jdragon3001/SO-ARM100/Build/A1mini/follower/follower_plate_02.stl

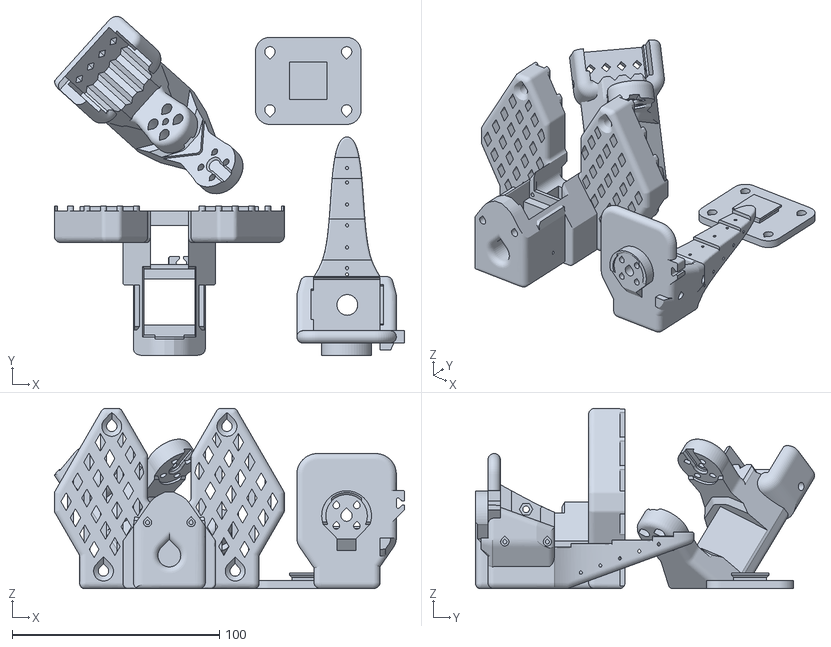
[picture p1: CAD file, 2026-11-04]
Build/A1mini/follower/follower_plate_02.stl
168.9 x 163.5 x 87.0
