jdragon3001/SO-ARM100/Build/A1mini/leader/leader_plate_03.stl

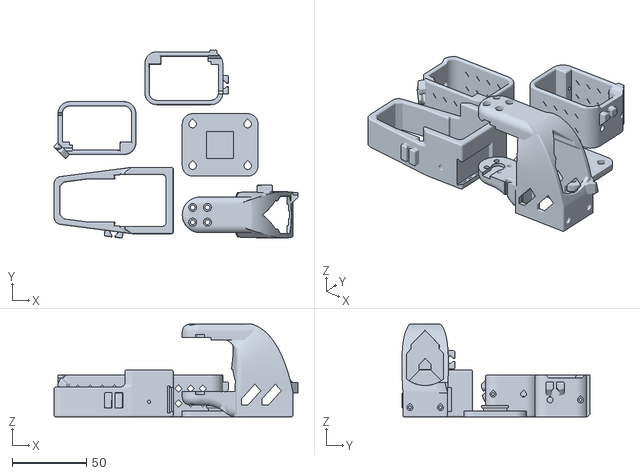
[picture p2: CAD file, 2026-11-04]
Build/A1mini/leader/leader_plate_03.stl
164.0 x 126.6 x 62.3
