jdragon3001/SO-ARM100/Build/Tooling/inspection/receiver_section.stl

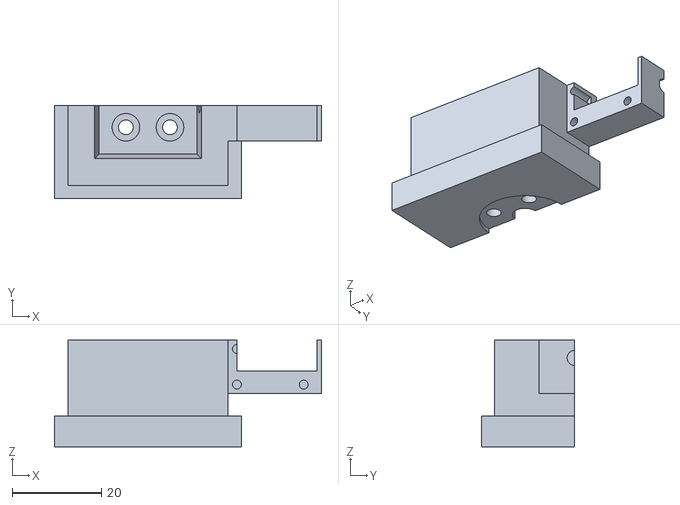
[picture p3: CAD file, 2026-11-07]
Build/Tooling/inspection/receiver_section.stl
60.0 x 21.0 x 24.0
