jdragon3001/SO-ARM100/Build/Tooling/parts/dock_stirrer_lower_1.step

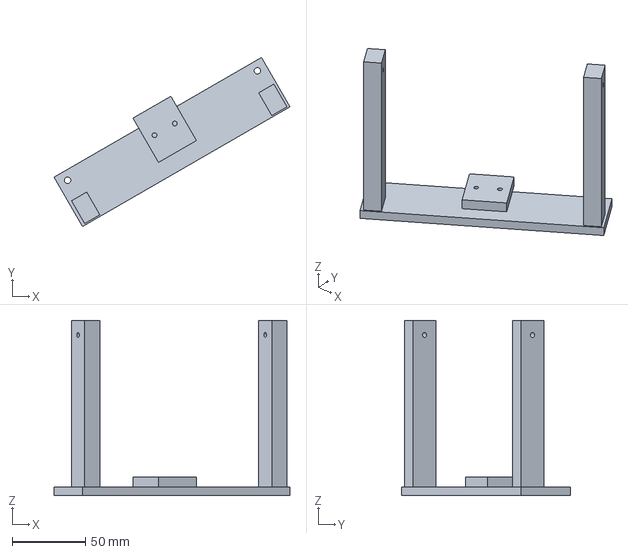
[picture p4: CAD file, 2026-11-07]
Build/Tooling/parts/dock_stirrer_lower_1.step
161.5 x 115.7 x 120.0 mm
