jdragon3001/SO-ARM100/Build/A1mini/follower/follower_plate_01.stl

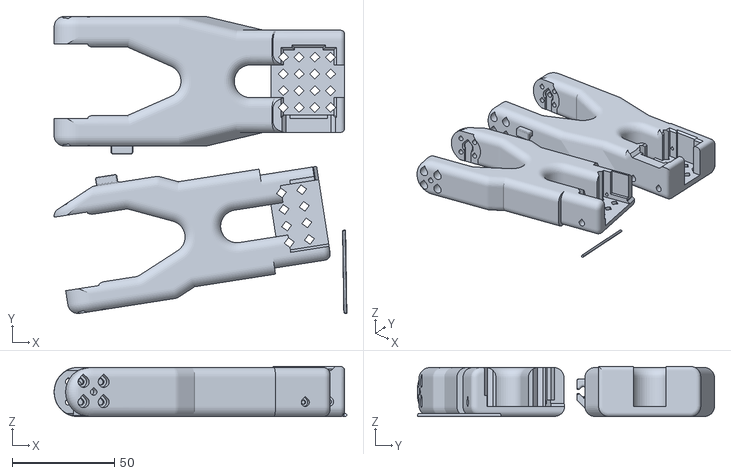
[picture p5: CAD file, 2026-11-04]
Build/A1mini/follower/follower_plate_01.stl
143.2 x 145.3 x 24.5
