jdragon3001/SO-ARM100/Build/A1mini/leader/leader_plate_02.stl

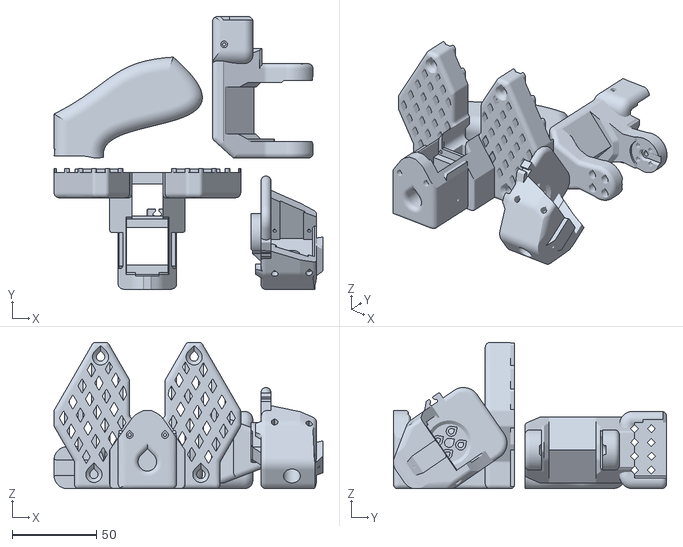
[picture p6: CAD file, 2026-11-04]
Build/A1mini/leader/leader_plate_02.stl
159.8 x 162.2 x 87.0
