jdragon3001/SO-ARM100/Build/Tooling/inspection/test_plug_section.stl

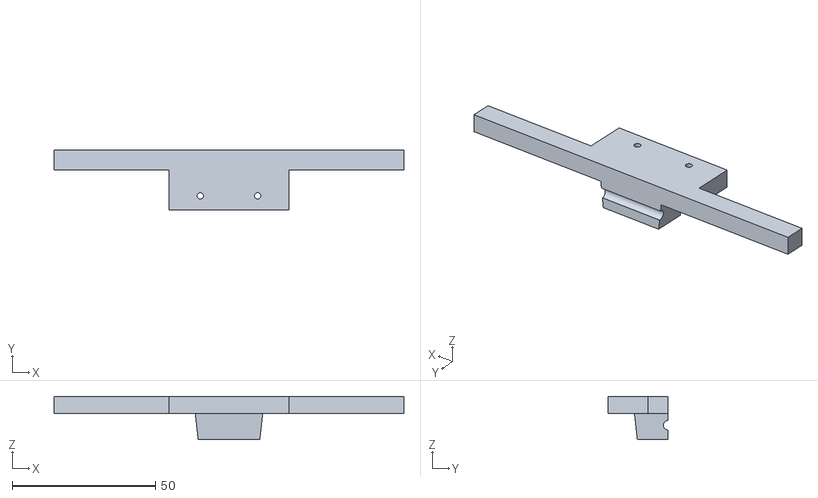
[picture p7: CAD file, 2026-11-07]
Build/Tooling/inspection/test_plug_section.stl
122.0 x 21.0 x 15.0
