jdragon3001/SO-ARM100/Build/Tooling/parts/dock_soft_gripper_upper_1.step

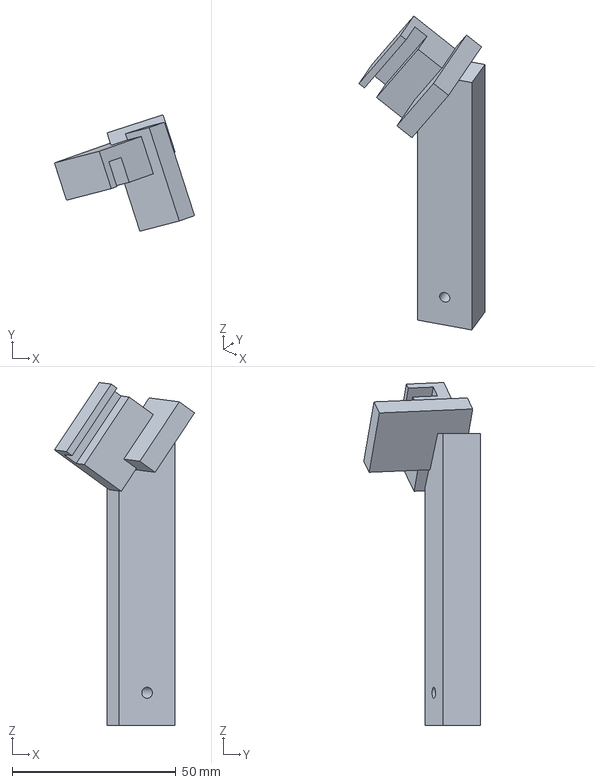
[picture p8: CAD file, 2026-11-07]
Build/Tooling/parts/dock_soft_gripper_upper_1.step
42.8 x 35.6 x 104.8 mm
