jdragon3001/SO-ARM100/Build/A1mini/follower/follower_plate_03.stl

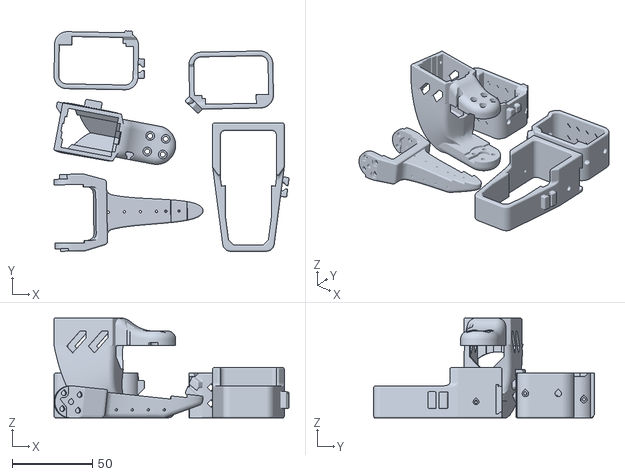
[picture p9: CAD file, 2026-11-04]
Build/A1mini/follower/follower_plate_03.stl
146.7 x 137.7 x 62.3
