jdragon3001/SO-ARM100/Build/A1mini/leader/leader_plate_01.stl

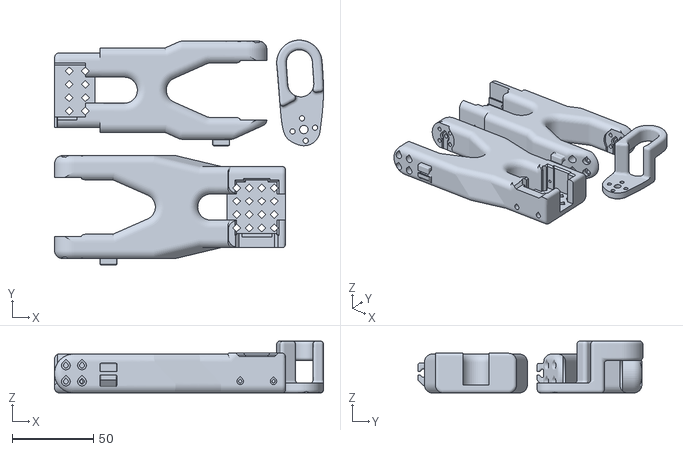
[picture p10: CAD file, 2026-11-04]
Build/A1mini/leader/leader_plate_01.stl
165.6 x 138.3 x 32.0
