jdragon3001/SO-ARM100/Build/Tooling/parts/dock_soft_gripper_lower_1.step

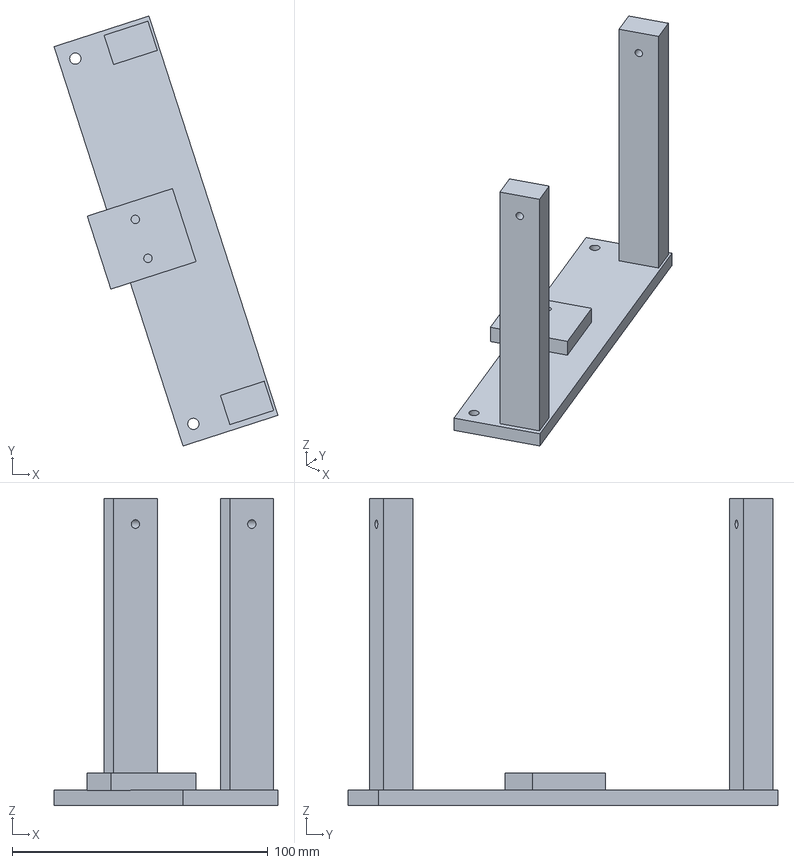
[picture p11: CAD file, 2026-11-07]
Build/Tooling/parts/dock_soft_gripper_lower_1.step
87.5 x 168.0 x 120.0 mm
