jdragon3001/SO-ARM100/Build/Tooling/parts/dock_spatula_upper_2.step

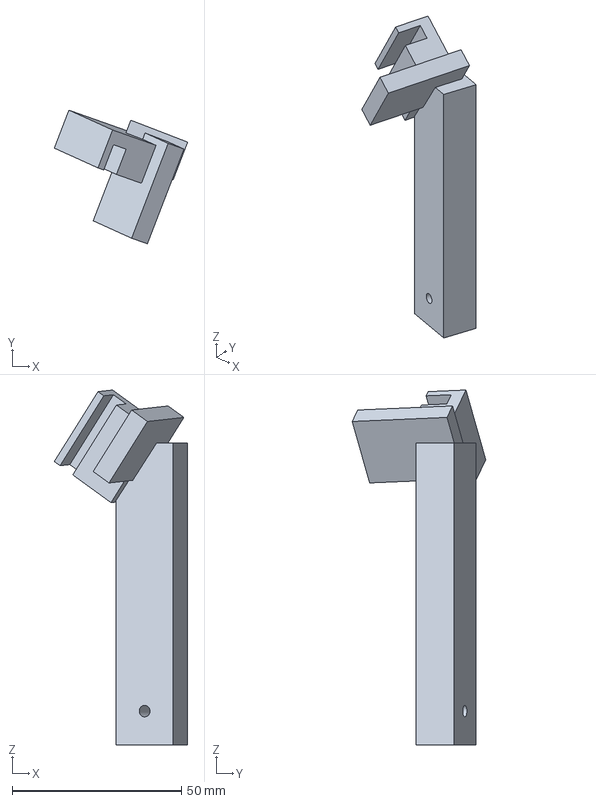
[picture p12: CAD file, 2026-11-07]
Build/Tooling/parts/dock_spatula_upper_2.step
39.4 x 39.4 x 104.8 mm
