jdragon3001/SO-ARM100/Build/Tooling/parts/dock_stirrer_upper_1.step

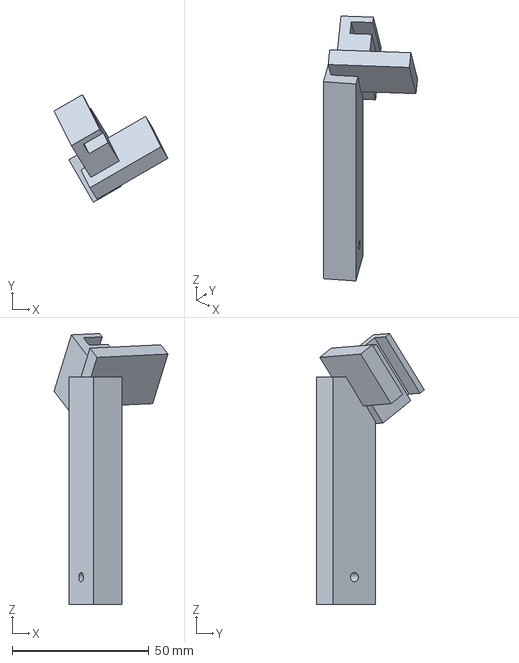
[picture p13: CAD file, 2026-11-07]
Build/Tooling/parts/dock_stirrer_upper_1.step
41.7 x 39.4 x 99.1 mm
