jdragon3001/SO-ARM100/Build/Tooling/parts/dock_retaining_gate.step

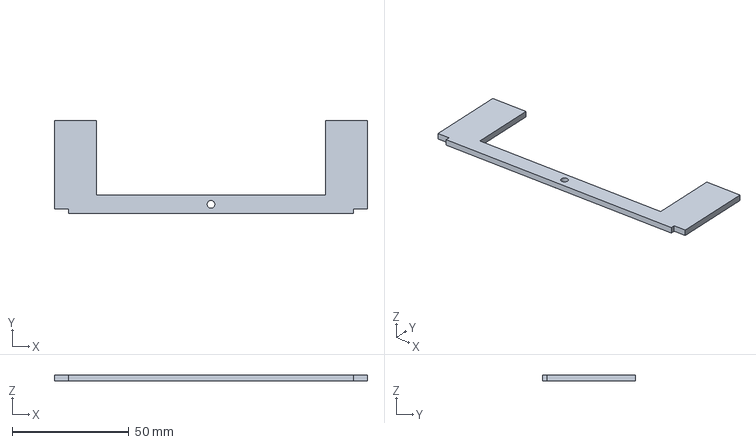
[picture p14: CAD file, 2026-11-07]
Build/Tooling/parts/dock_retaining_gate.step
134.0 x 40.0 x 2.70 mm
