jdragon3001/SO-ARM100/Build/Tooling/parts/dock_gripper_upper_2.step

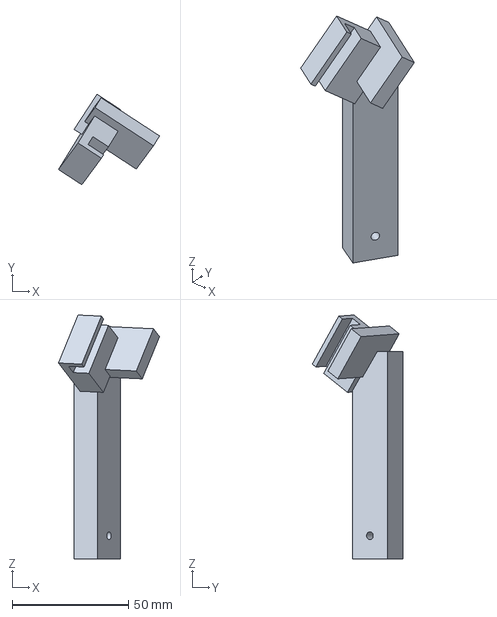
[picture p15: CAD file, 2026-11-07]
Build/Tooling/parts/dock_gripper_upper_2.step
43.4 x 38.9 x 104.8 mm
