jdragon3001/SO-ARM100/Build/Tooling/parts/dock_soft_gripper_upper_2.step

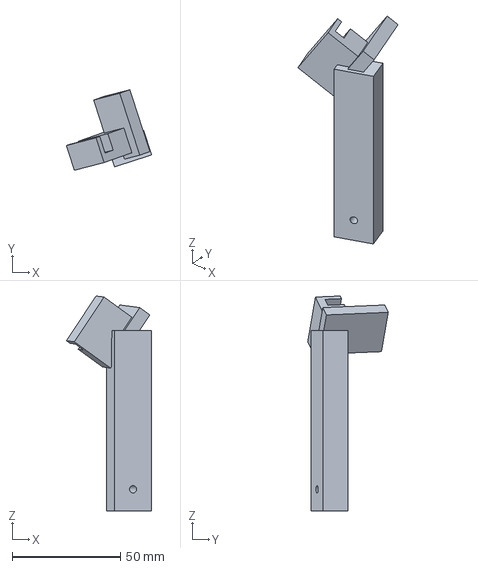
[picture p16: CAD file, 2026-11-07]
Build/Tooling/parts/dock_soft_gripper_upper_2.step
39.3 x 37.2 x 99.1 mm
