jdragon3001/SO-ARM100/Build/Tooling/parts/dock_spatula_upper_1.step

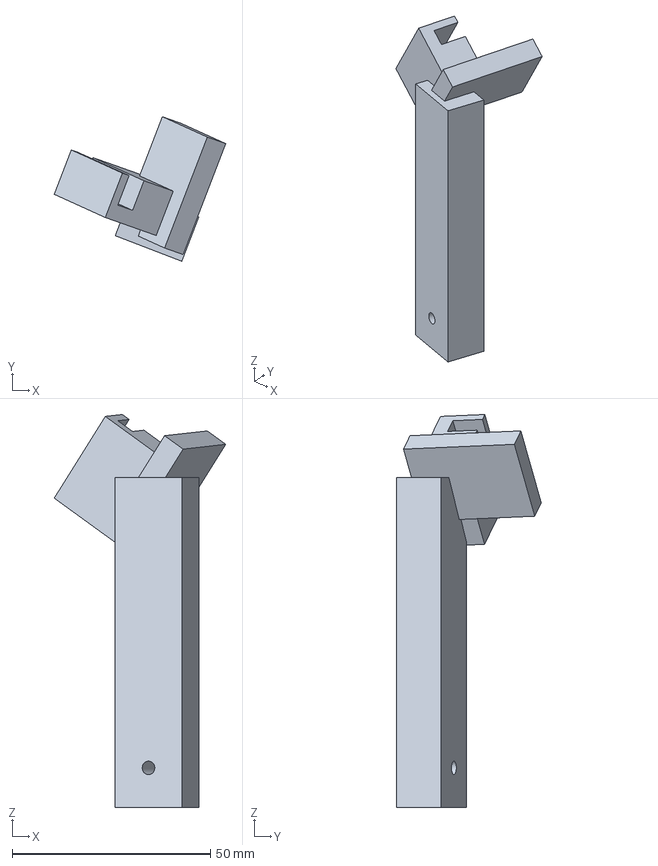
[picture p17: CAD file, 2026-11-07]
Build/Tooling/parts/dock_spatula_upper_1.step
43.3 x 36.5 x 99.1 mm
