jdragon3001/SO-ARM100/Build/Tooling/parts/dock_gripper_upper_1.step

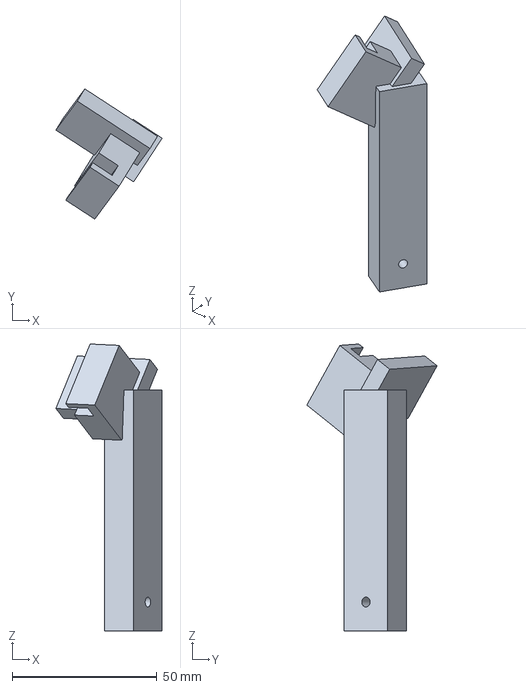
[picture p18: CAD file, 2026-11-07]
Build/Tooling/parts/dock_gripper_upper_1.step
36.7 x 45.0 x 99.1 mm
