jdragon3001/SO-ARM100/Build/Tooling/parts/dock_gripper.step

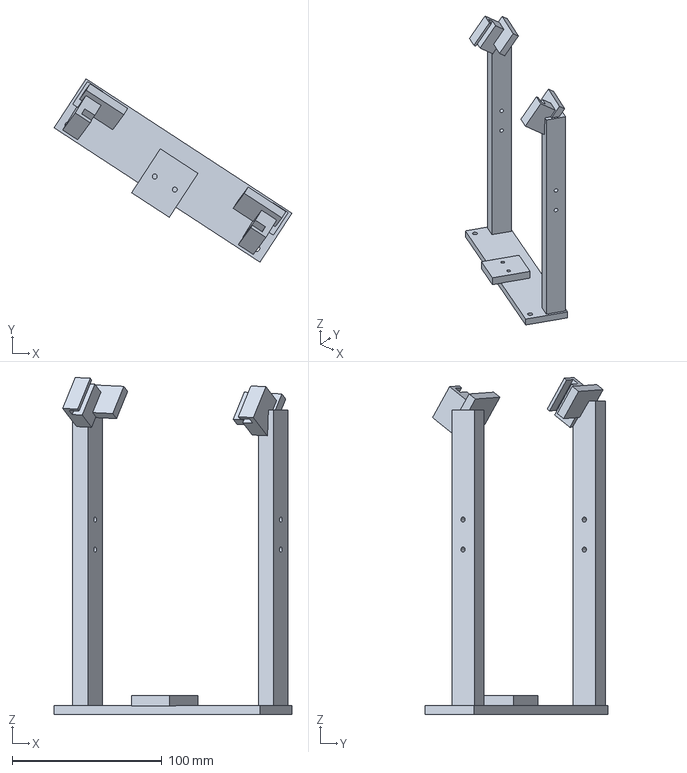
[picture p19: CAD file, 2026-11-07]
Build/Tooling/parts/dock_gripper.step
158.7 x 122.3 x 224.8 mm
