jdragon3001/SO-ARM100/Build/Tooling/parts/dock_stirrer_upper_2.step

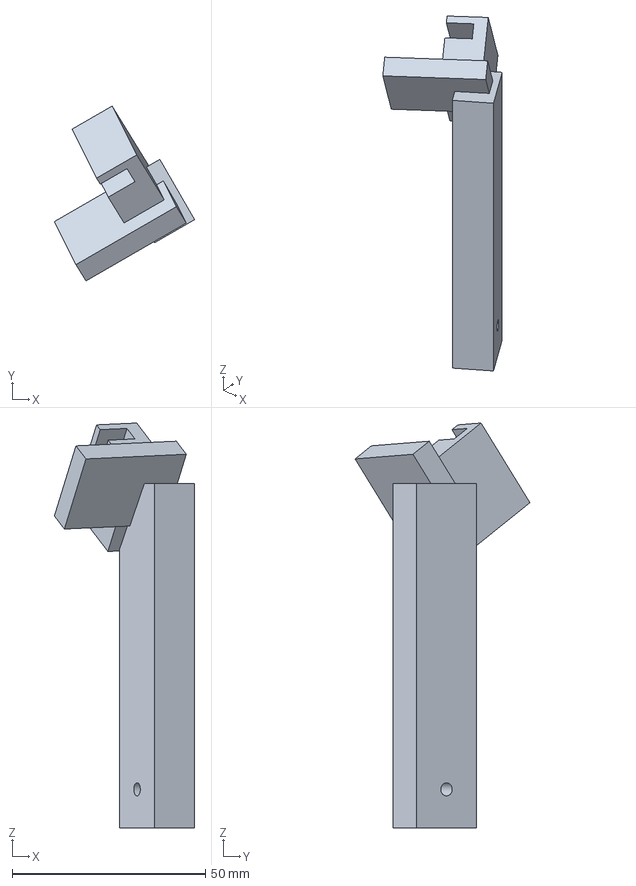
[picture p20: CAD file, 2026-11-07]
Build/Tooling/parts/dock_stirrer_upper_2.step
36.3 x 45.2 x 104.8 mm
