jdragon3001/SO-ARM100/Build/Tooling/parts/dock_spatula.step

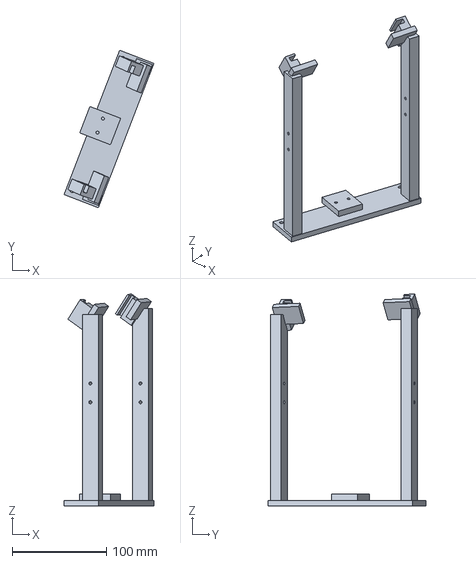
[picture p21: CAD file, 2026-11-07]
Build/Tooling/parts/dock_spatula.step
95.3 x 167.1 x 224.8 mm
