jdragon3001/SO-ARM100/Build/Tooling/parts/dock_spatula_lower_1.step

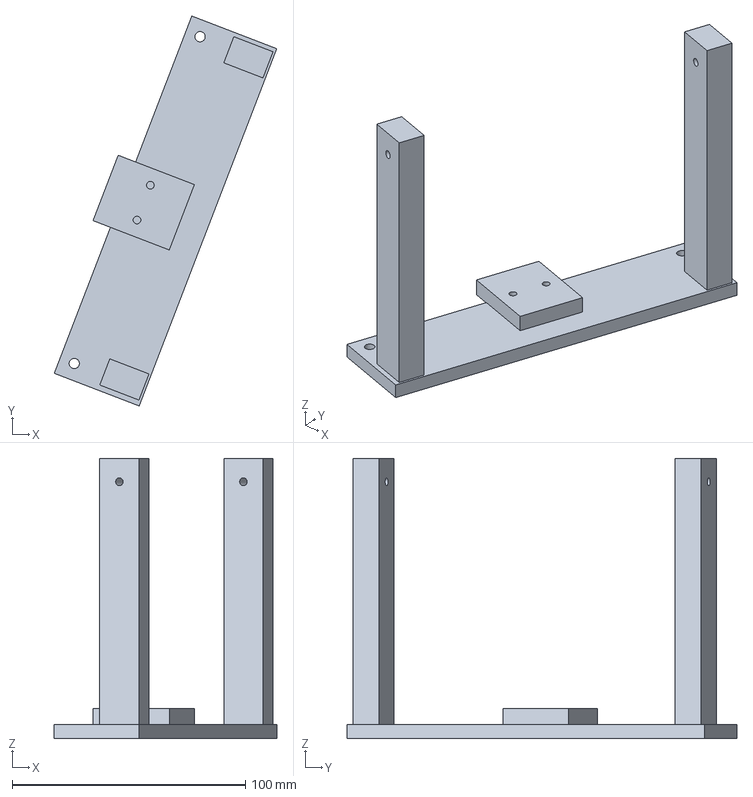
[picture p22: CAD file, 2026-11-07]
Build/Tooling/parts/dock_spatula_lower_1.step
95.3 x 167.1 x 120.0 mm
