jdragon3001/SO-ARM100/Build/Tooling/parts/dock_soft_gripper.step

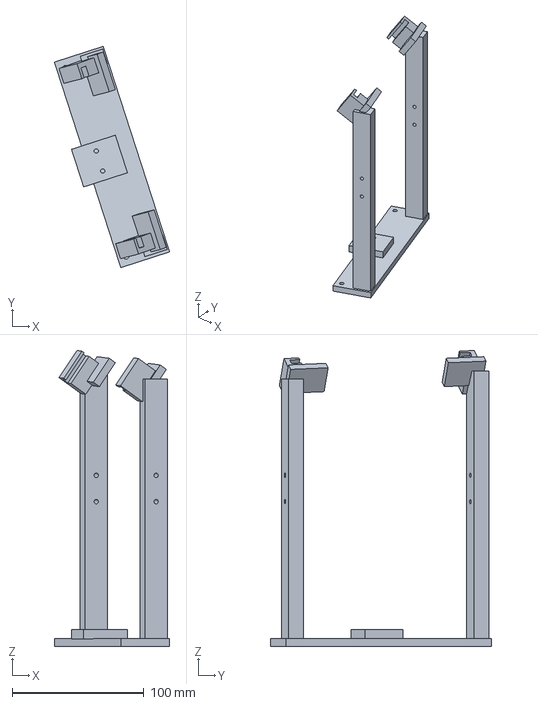
[picture p23: CAD file, 2026-11-07]
Build/Tooling/parts/dock_soft_gripper.step
87.5 x 168.0 x 224.8 mm
