jdragon3001/SO-ARM100/Build/Tooling/parts/tendon_equalizer_primary.step

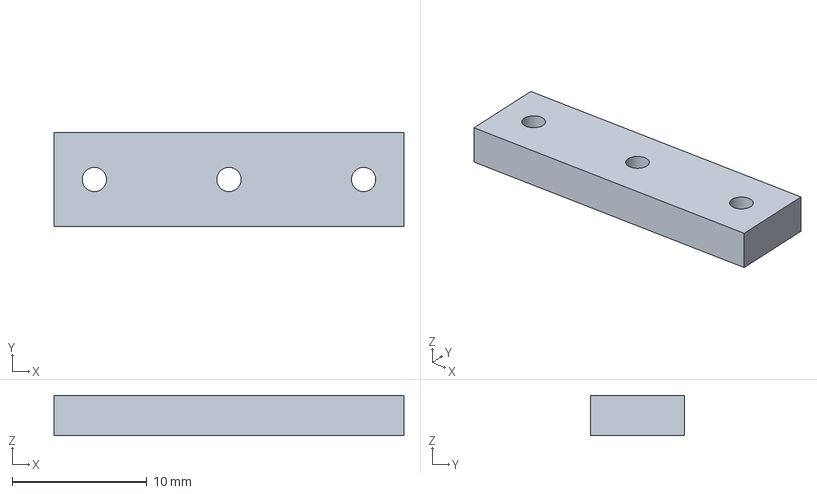
[picture p24: CAD file, 2026-11-07]
Build/Tooling/parts/tendon_equalizer_primary.step
26.0 x 7.00 x 3.00 mm
