jdragon3001/SO-ARM100/Build/Tooling/parts/tendon_spool.step

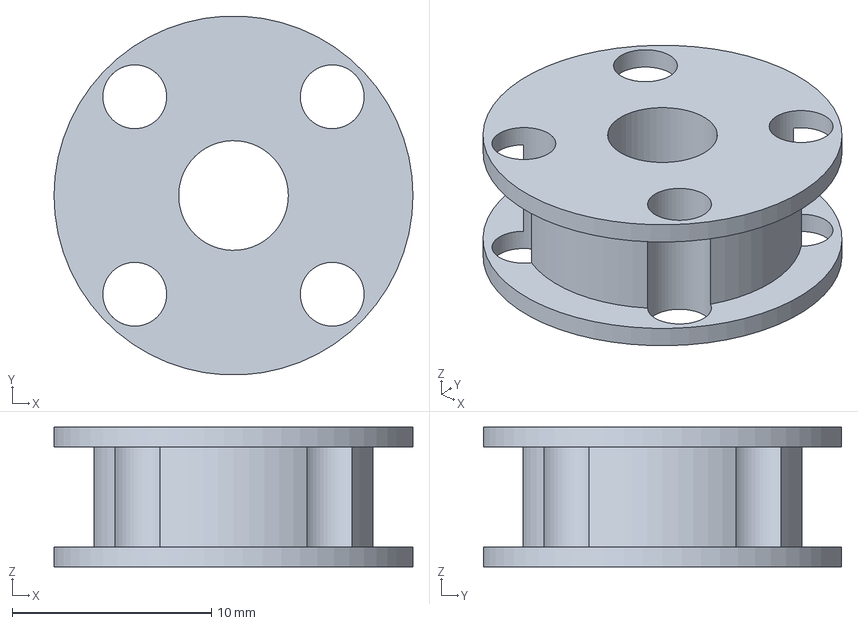
[picture p25: CAD file, 2026-11-07]
Build/Tooling/parts/tendon_spool.step
18.0 x 18.0 x 7.00 mm
