jdragon3001/SO-ARM100/Build/Tooling/parts/soft_finger_print_four.step

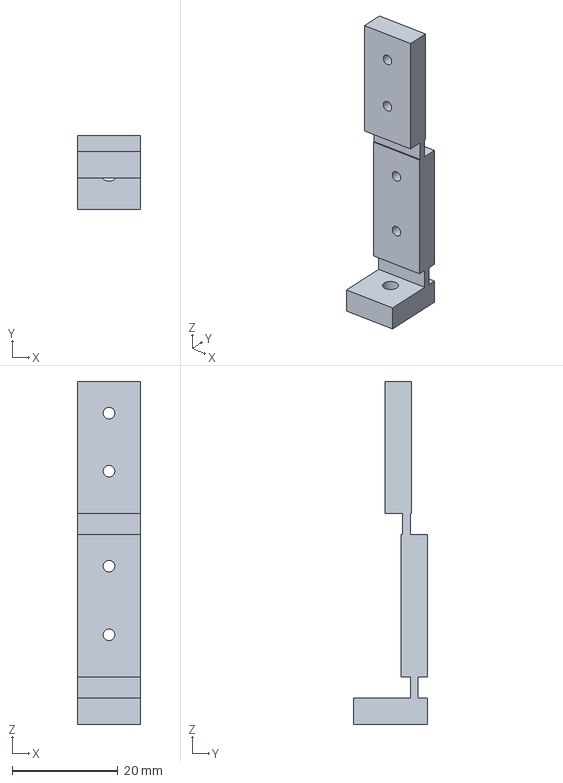
[picture p26: CAD file, 2026-11-07]
Build/Tooling/parts/soft_finger_print_four.step
12.0 x 14.0 x 65.0 mm
