jdragon3001/SO-ARM100/Build/Tooling/parts/stirrer_front_shell.step

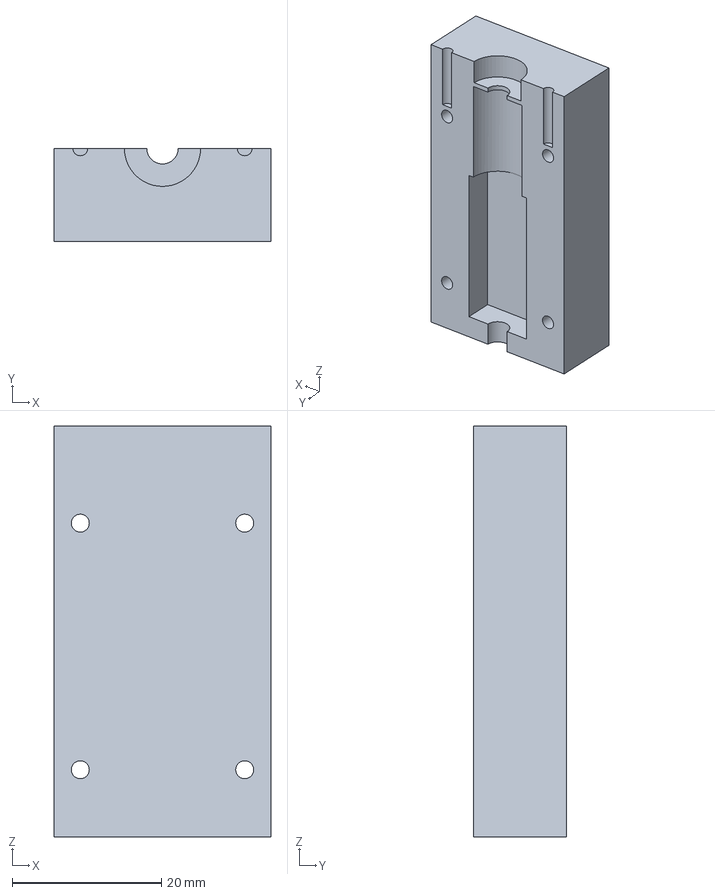
[picture p27: CAD file, 2026-11-07]
Build/Tooling/parts/stirrer_front_shell.step
29.0 x 12.5 x 55.0 mm
