jdragon3001/SO-ARM100/Build/Tooling/parts/gripper_body.step

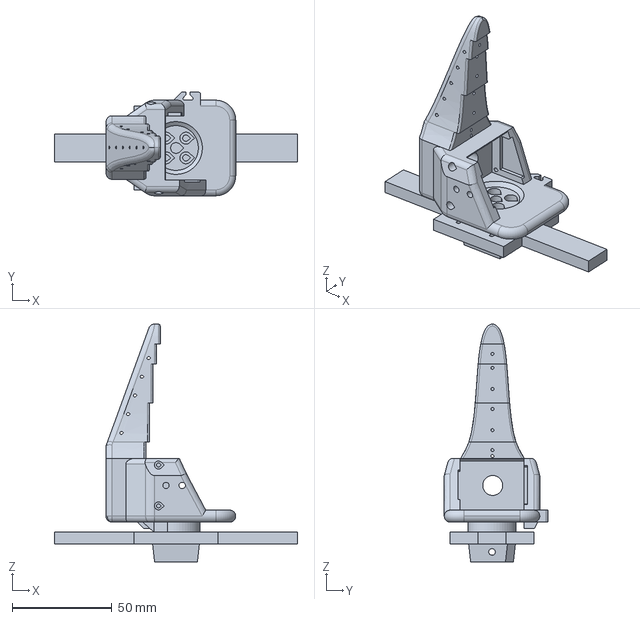
[picture p28: CAD file, 2026-11-07]
Build/Tooling/parts/gripper_body.step
122.0 x 52.0 x 119.4 mm
