jdragon3001/SO-ARM100/Build/Tooling/parts/dock_servo_crank.step

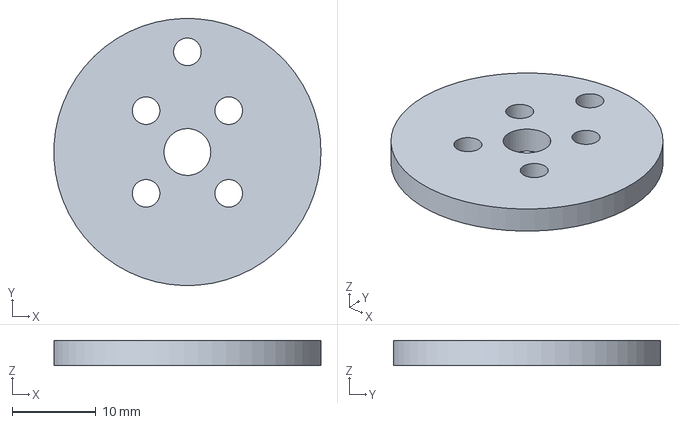
[picture p29: CAD file, 2026-11-07]
Build/Tooling/parts/dock_servo_crank.step
32.0 x 32.0 x 3.00 mm
