jdragon3001/SO-ARM100/Build/Tooling/parts/pin_housing_cover.step

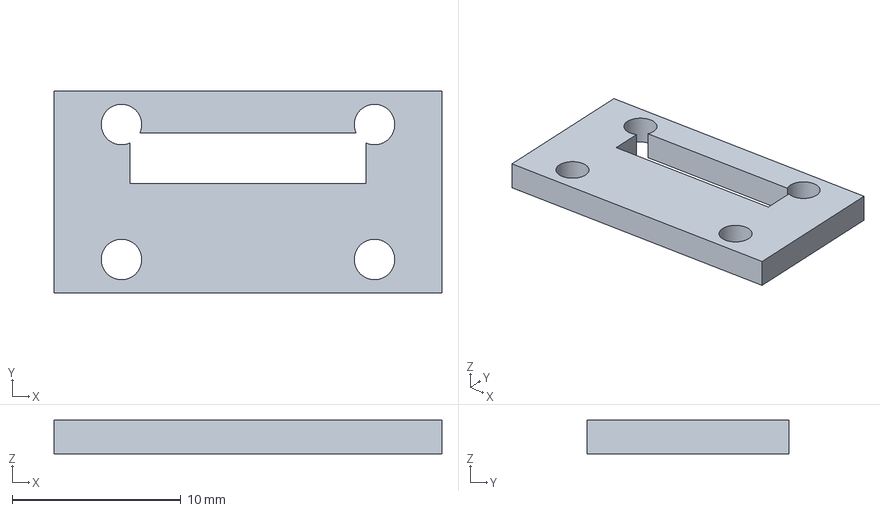
[picture p30: CAD file, 2026-11-07]
Build/Tooling/parts/pin_housing_cover.step
23.0 x 12.0 x 2.00 mm
