jdragon3001/SO-ARM100/Build/Tooling/parts/stirrer_lid.step

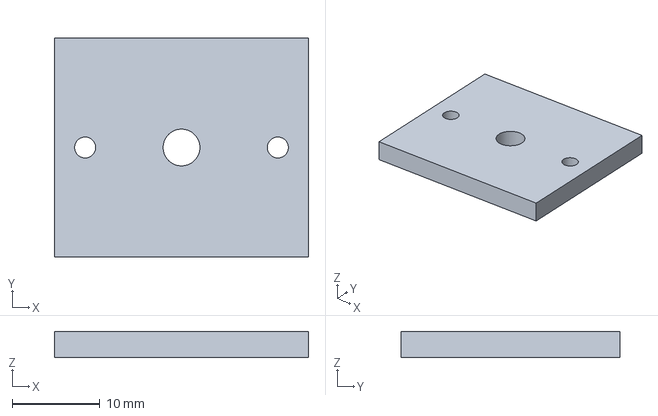
[picture p31: CAD file, 2026-11-07]
Build/Tooling/parts/stirrer_lid.step
29.0 x 25.0 x 3.00 mm
