jdragon3001/SO-ARM100/Build/Tooling/parts/tendon_equalizer_secondary.step

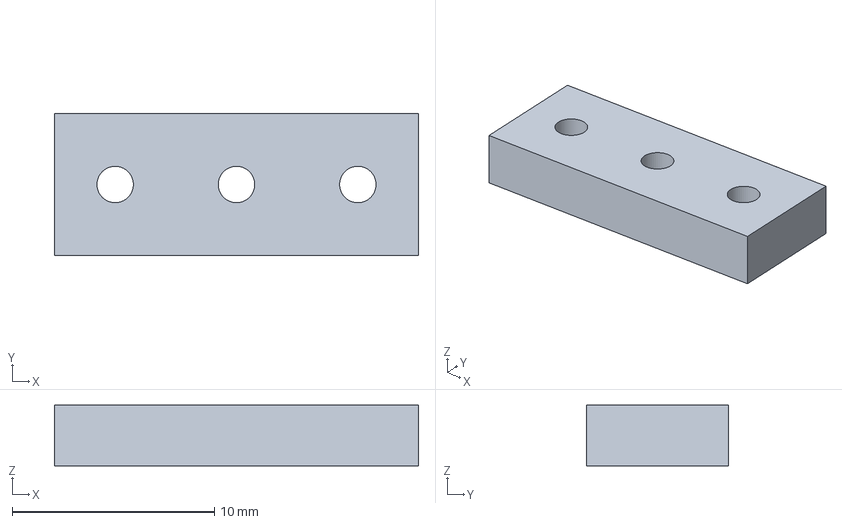
[picture p32: CAD file, 2026-11-07]
Build/Tooling/parts/tendon_equalizer_secondary.step
18.0 x 7.00 x 3.00 mm
