jdragon3001/SO-ARM100/Build/Tooling/parts/spatula_clamp.step

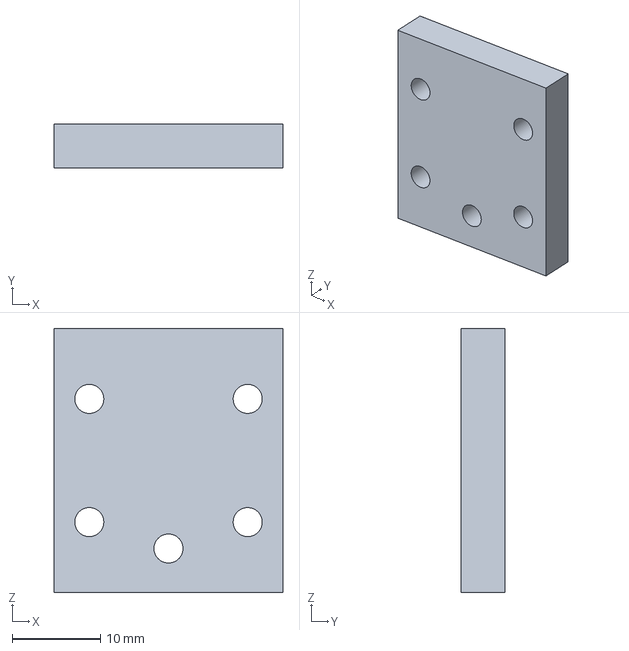
[picture p33: CAD file, 2026-11-07]
Build/Tooling/parts/spatula_clamp.step
26.0 x 5.00 x 30.0 mm
