jdragon3001/SO-ARM100/Build/Tooling/parts/spatula_holder.step

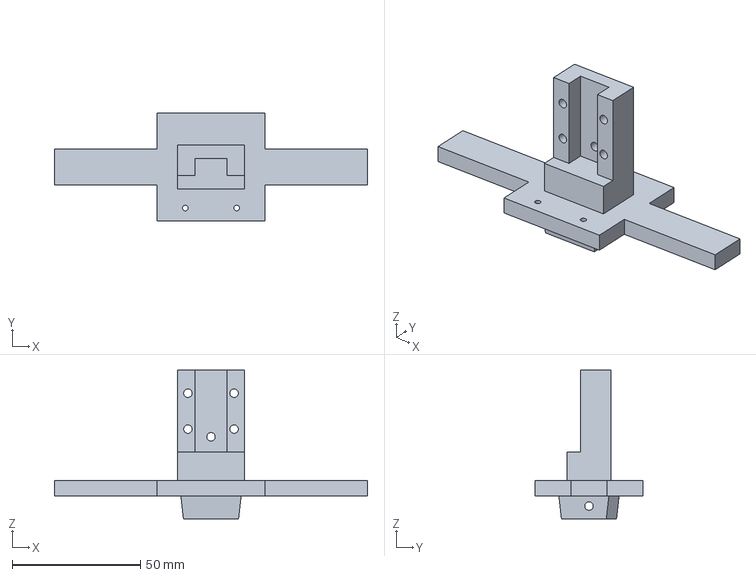
[picture p34: CAD file, 2026-11-07]
Build/Tooling/parts/spatula_holder.step
122.0 x 42.0 x 58.0 mm
