jdragon3001/SO-ARM100/Build/Tooling/parts/stirrer_housing.step

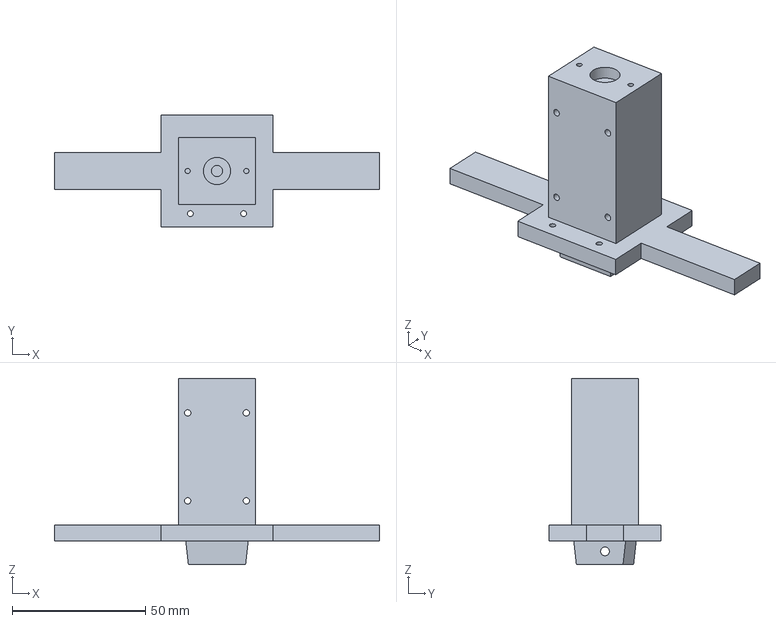
[picture p35: CAD file, 2026-11-07]
Build/Tooling/parts/stirrer_housing.step
122.0 x 42.0 x 70.0 mm
