jdragon3001/SO-ARM100/Build/Tooling/parts/contact_carrier_fit_coupon.step

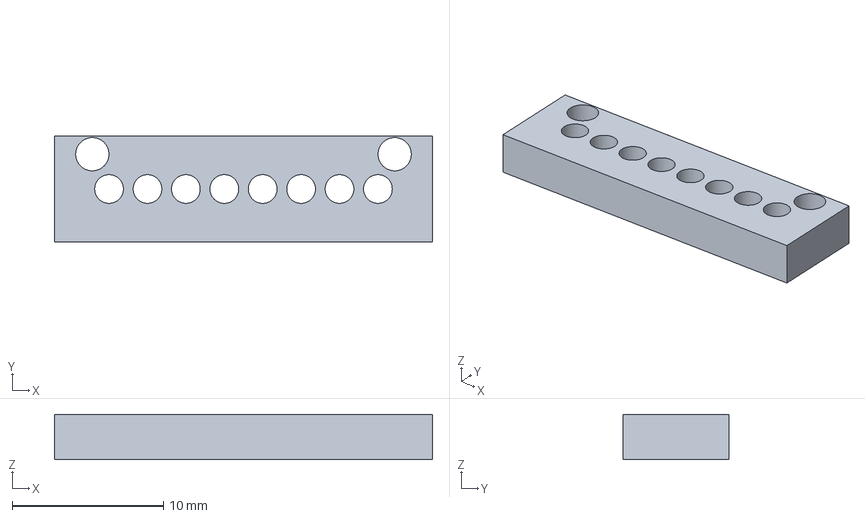
[picture p36: CAD file, 2026-11-07]
Build/Tooling/parts/contact_carrier_fit_coupon.step
25.0 x 7.00 x 3.00 mm
