jdragon3001/SO-ARM100/Build/Tooling/parts/socket_coupon_25.step

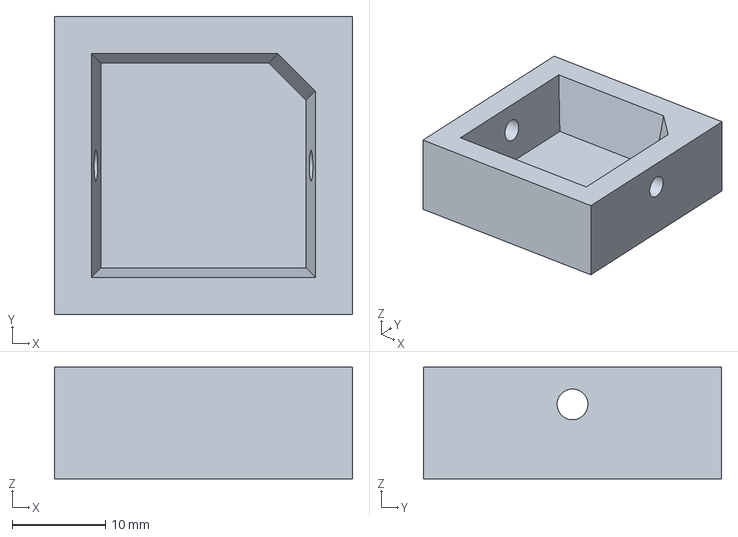
[picture p37: CAD file, 2026-11-07]
Build/Tooling/parts/socket_coupon_25.step
32.0 x 32.0 x 12.0 mm
