jdragon3001/SO-ARM100/Build/Tooling/parts/dock_servo_cradle.step

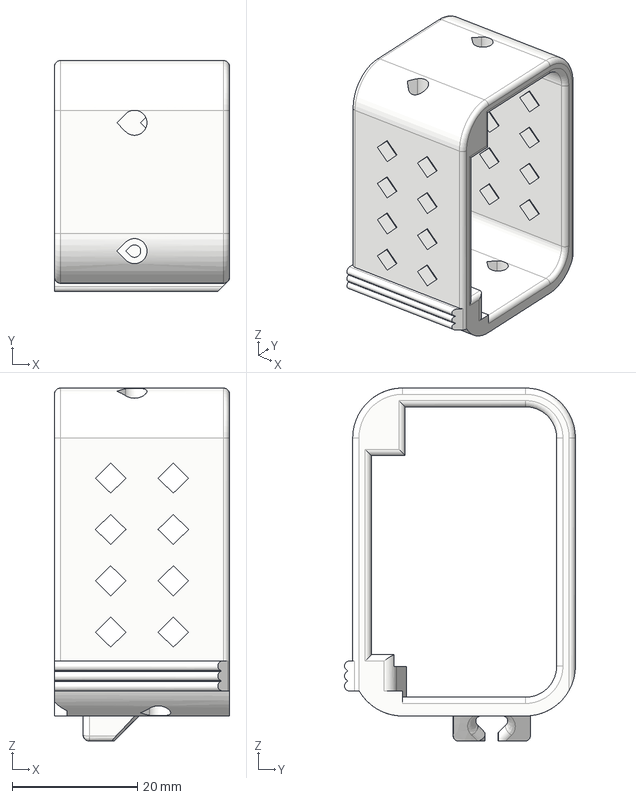
[picture p38: CAD file, 2026-11-07]
Build/Tooling/parts/dock_servo_cradle.step
28.0 x 36.9 x 56.4 mm
Wiring_holder_v1
Wiring_holder_v1__1_
