jdragon3001/SO-ARM100/Build/Tooling/parts/pin_collar.step

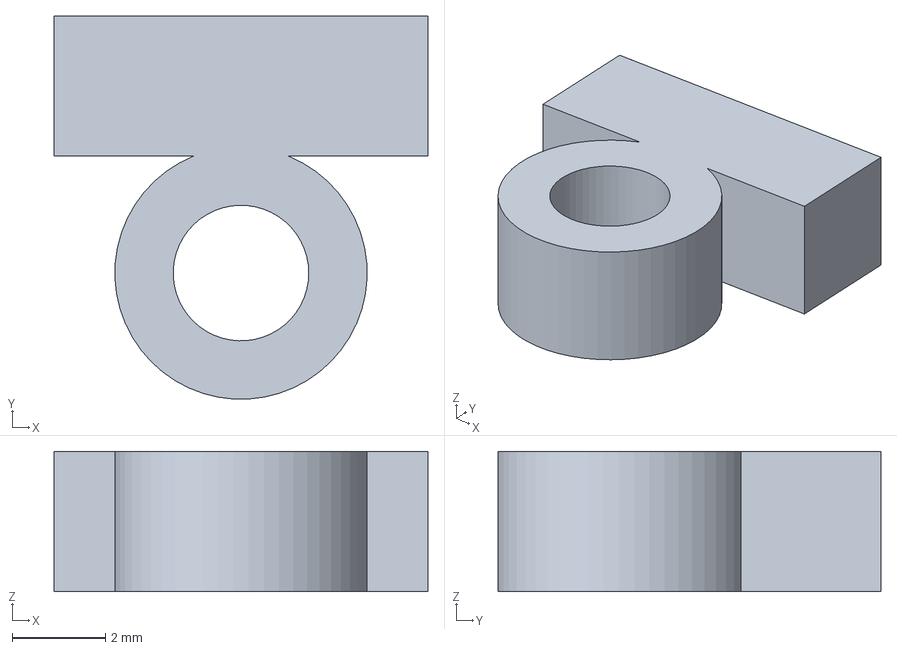
[picture p39: CAD file, 2026-11-07]
Build/Tooling/parts/pin_collar.step
8.00 x 8.19 x 3.00 mm
