jdragon3001/SO-ARM100/Build/Tooling/parts/receiver.step

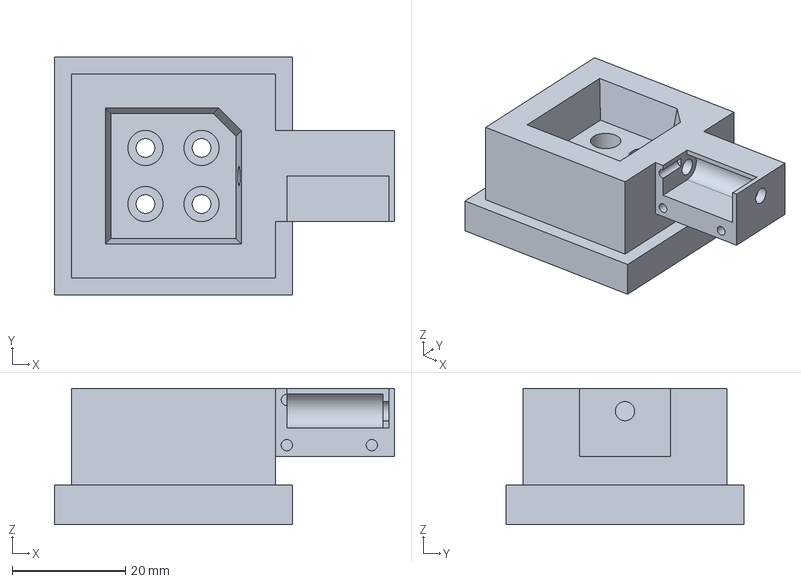
[picture p40: CAD file, 2026-11-07]
Build/Tooling/parts/receiver.step
60.0 x 42.0 x 24.0 mm
