jdragon3001/SO-ARM100/Build/Tooling/parts/test_plug.step

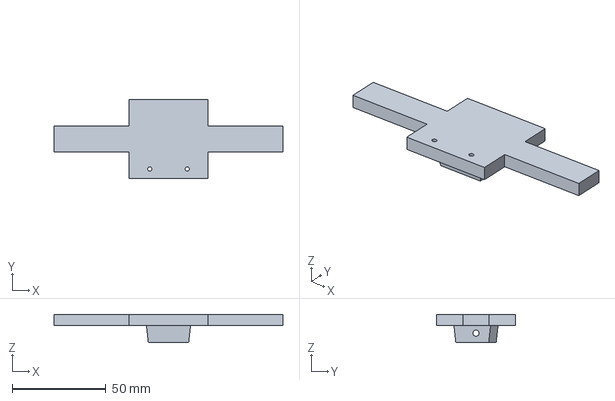
[picture p41: CAD file, 2026-11-07]
Build/Tooling/parts/test_plug.step
122.0 x 42.0 x 15.0 mm
