jdragon3001/SO-ARM100/Build/Tooling/parts/dock_release_fork.step

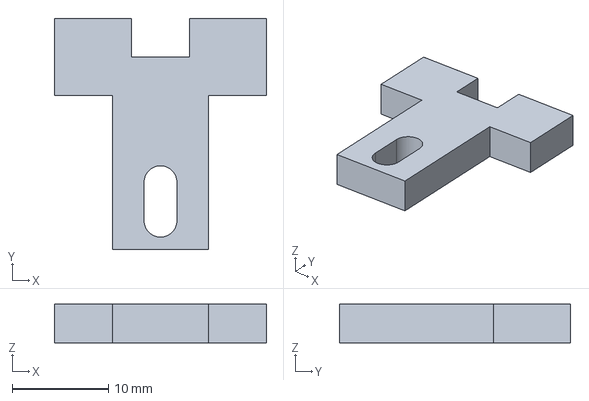
[picture p42: CAD file, 2026-11-07]
Build/Tooling/parts/dock_release_fork.step
22.0 x 24.0 x 4.00 mm
