jdragon3001/SO-ARM100/Build/Tooling/parts/four_finger_lid.step

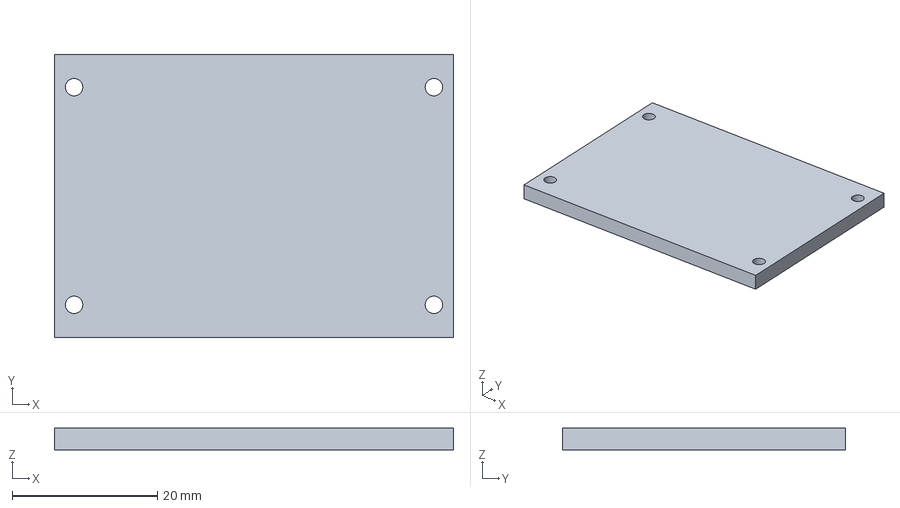
[picture p43: CAD file, 2026-11-07]
Build/Tooling/parts/four_finger_lid.step
55.0 x 39.0 x 3.00 mm
