jdragon3001/SO-ARM100/Build/Tooling/parts/dock_post_splice_print_eight.step

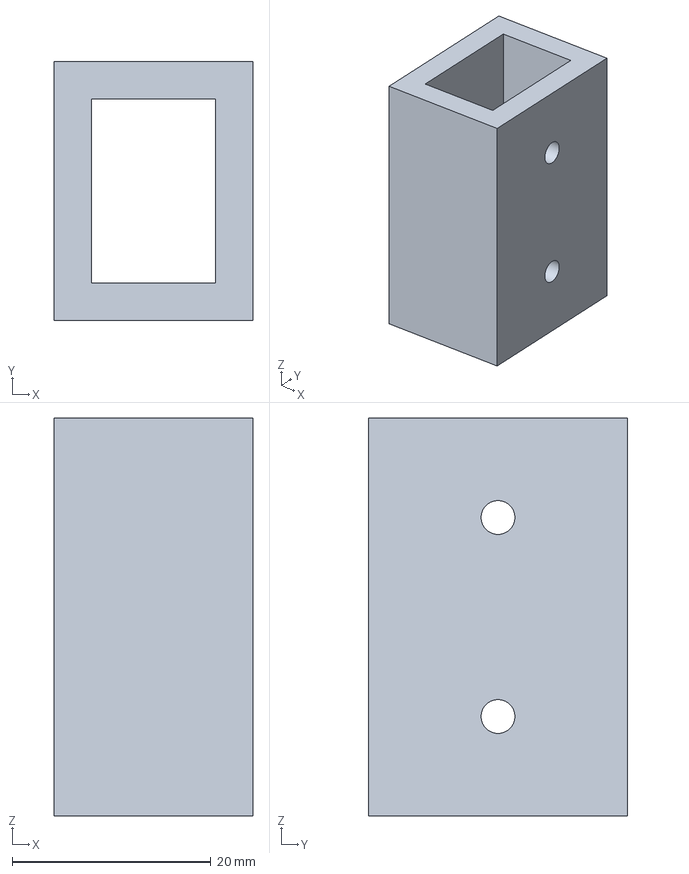
[picture p44: CAD file, 2026-11-07]
Build/Tooling/parts/dock_post_splice_print_eight.step
20.0 x 26.0 x 40.0 mm
