jdragon3001/SO-ARM100/Build/Tooling/parts/stirrer_back_shell.step

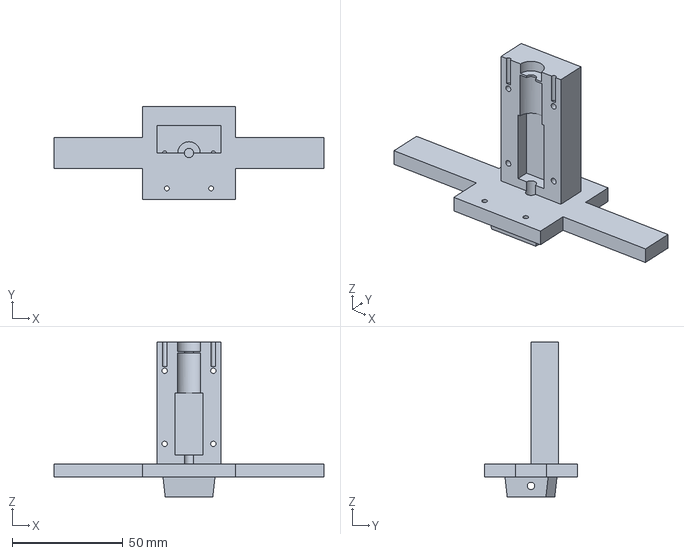
[picture p45: CAD file, 2026-11-07]
Build/Tooling/parts/stirrer_back_shell.step
122.0 x 42.0 x 70.0 mm
