jdragon3001/SO-ARM100/Build/Tooling/parts/equalizer_guard.step

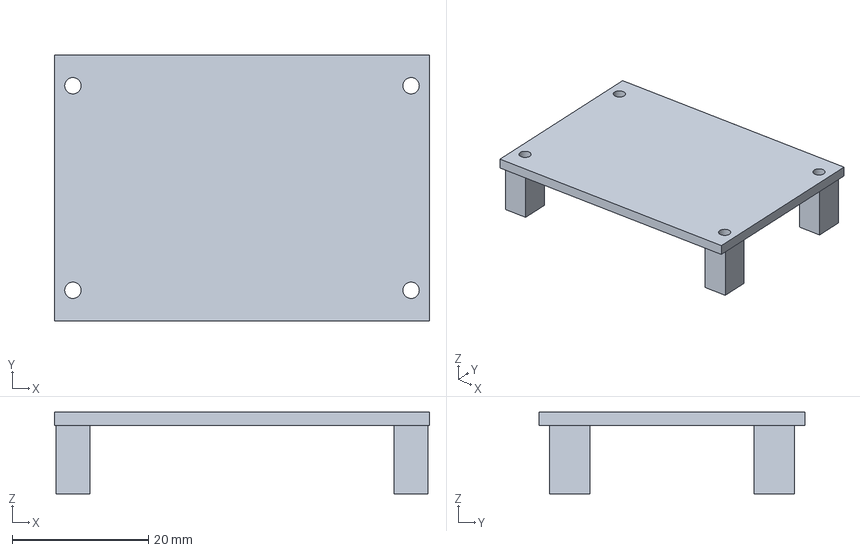
[picture p46: CAD file, 2026-11-07]
Build/Tooling/parts/equalizer_guard.step
55.0 x 39.0 x 12.0 mm
