jdragon3001/SO-ARM100/Build/Tooling/parts/camera_bracket_32mm.step

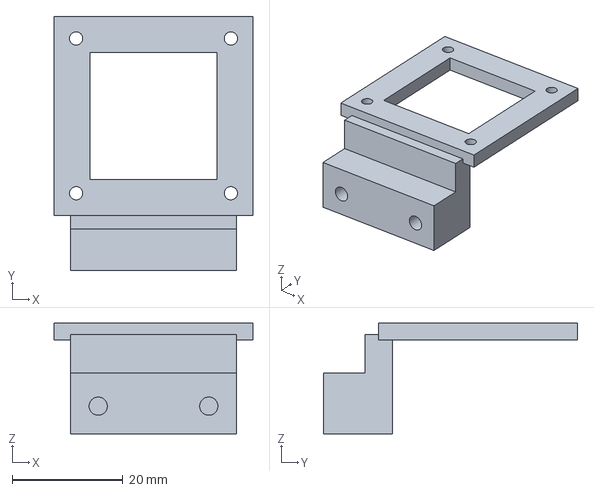
[picture p47: CAD file, 2026-11-07]
Build/Tooling/parts/camera_bracket_32mm.step
36.0 x 46.0 x 20.0 mm
