jdragon3001/SO-ARM100/Build/Tooling/parts/four_finger_palm.step

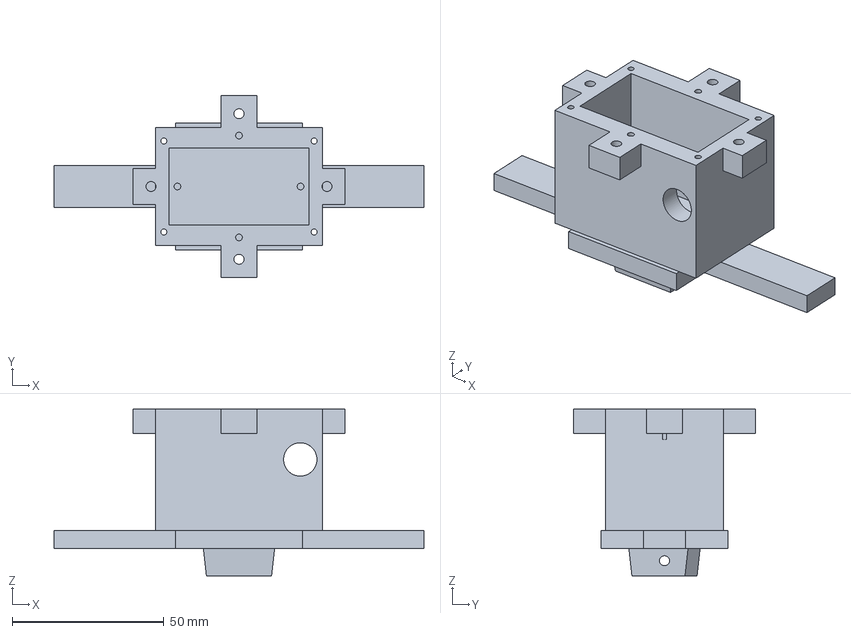
[picture p48: CAD file, 2026-11-07]
Build/Tooling/parts/four_finger_palm.step
122.0 x 60.0 x 55.0 mm
