jdragon3001/SO-ARM100/Build/Tooling/parts/gripper_jaw_1.step

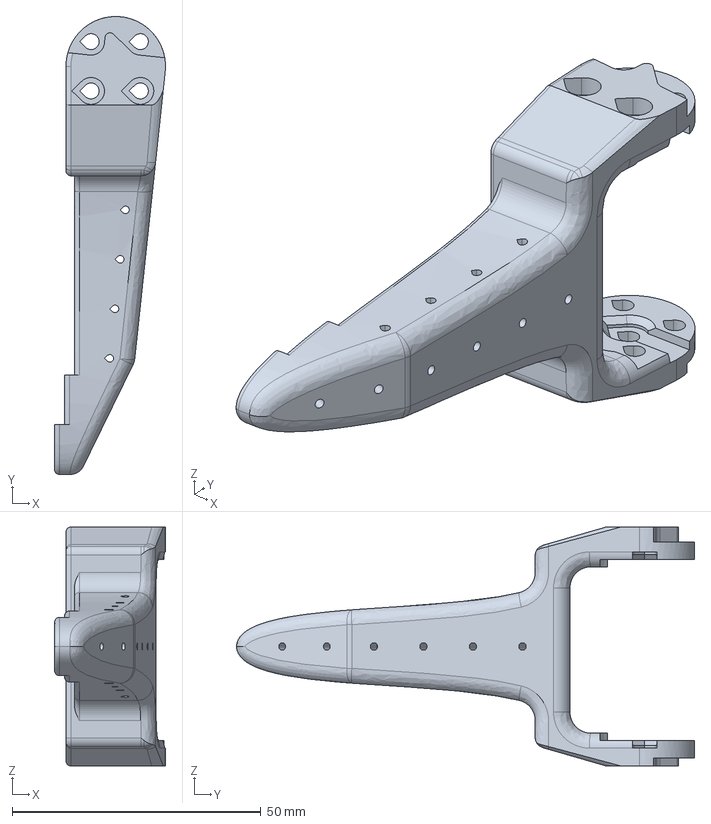
[picture p49: CAD file, 2026-11-07]
Build/Tooling/parts/gripper_jaw_1.step
22.3 x 92.0 x 48.0 mm
