jdragon3001/SO-ARM100/Build/Tooling/parts/shaft_coupling_fit_coupon.step

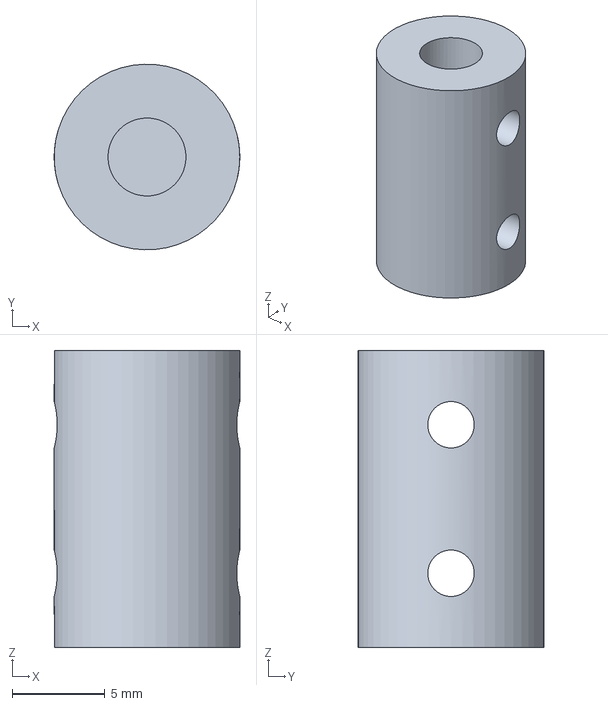
[picture p50: CAD file, 2026-11-07]
Build/Tooling/parts/shaft_coupling_fit_coupon.step
10.0 x 10.00 x 16.0 mm
