jdragon3001/SO-ARM100/(list of files, cad)

Other CAD files:
Build/Tooling/parts/dock_gripper_lower_1.step
Build/Tooling/parts/dock_stirrer.step
Build/Tooling/parts/socket_coupon_35.step
Build/Tooling/parts/socket_coupon_15.step
Build/Tooling/parts/camera_bracket_32mm.stl
Build/Tooling/parts/contact_carrier_fit_coupon.stl
Build/Tooling/parts/dock_gripper.stl
Build/Tooling/parts/dock_gripper_lower_1.stl
Build/Tooling/parts/dock_gripper_upper_1.stl
Build/Tooling/parts/dock_gripper_upper_2.stl
Build/Tooling/parts/dock_post_splice_print_eight.stl
Build/Tooling/parts/dock_release_fork.stl
Build/Tooling/parts/dock_retaining_gate.stl
Build/Tooling/parts/dock_servo_cradle.stl
Build/Tooling/parts/dock_servo_crank.stl
Build/Tooling/parts/dock_soft_gripper.stl
Build/Tooling/parts/dock_soft_gripper_lower_1.stl
Build/Tooling/parts/dock_soft_gripper_upper_1.stl
Build/Tooling/parts/dock_soft_gripper_upper_2.stl
Build/Tooling/parts/dock_spatula.stl
Build/Tooling/parts/dock_spatula_lower_1.stl
Build/Tooling/parts/dock_spatula_upper_1.stl
Build/Tooling/parts/dock_spatula_upper_2.stl
Build/Tooling/parts/dock_stirrer.stl
Build/Tooling/parts/dock_stirrer_lower_1.stl
Build/Tooling/parts/dock_stirrer_upper_1.stl
Build/Tooling/parts/dock_stirrer_upper_2.stl
Build/Tooling/parts/equalizer_guard.stl
Build/Tooling/parts/four_finger_lid.stl
Build/Tooling/parts/four_finger_palm.stl
Build/Tooling/parts/gripper_body.stl
Build/Tooling/parts/gripper_jaw_1.stl
Build/Tooling/parts/pin_collar.stl
Build/Tooling/parts/pin_housing_cover.stl
Build/Tooling/parts/receiver.stl
Build/Tooling/parts/shaft_coupling_fit_coupon.stl
Build/Tooling/parts/socket_coupon_15.stl
Build/Tooling/parts/socket_coupon_25.stl
Build/Tooling/parts/socket_coupon_35.stl
Build/Tooling/parts/soft_finger_print_four.stl
Build/Tooling/parts/spatula_clamp.stl
Build/Tooling/parts/spatula_holder.stl
Build/Tooling/parts/stirrer_back_shell.stl
Build/Tooling/parts/stirrer_front_shell.stl
Build/Tooling/parts/stirrer_housing.stl
Build/Tooling/parts/stirrer_lid.stl
Build/Tooling/parts/tendon_equalizer_primary.stl
Build/Tooling/parts/tendon_equalizer_secondary.stl
Build/Tooling/parts/tendon_spool.stl
Build/Tooling/parts/test_plug.stl
Build/Tooling/print/camera_bracket_32mm.stl
Build/Tooling/print/contact_carrier_fit_coupon.stl
Build/Tooling/print/dock_gripper_lower_1.stl
Build/Tooling/print/dock_gripper_upper_1.stl
Build/Tooling/print/dock_gripper_upper_2.stl
Build/Tooling/print/dock_post_splice_print_eight.stl
Build/Tooling/print/dock_release_fork.stl
Build/Tooling/print/dock_retaining_gate.stl
Build/Tooling/print/dock_servo_cradle.stl
Build/Tooling/print/dock_servo_crank.stl
Build/Tooling/print/dock_soft_gripper_lower_1.stl
Build/Tooling/print/dock_soft_gripper_upper_1.stl
Build/Tooling/print/dock_soft_gripper_upper_2.stl
Build/Tooling/print/dock_spatula_lower_1.stl
Build/Tooling/print/dock_spatula_upper_1.stl
Build/Tooling/print/dock_spatula_upper_2.stl
Build/Tooling/print/dock_stirrer_lower_1.stl
Build/Tooling/print/dock_stirrer_upper_1.stl
Build/Tooling/print/dock_stirrer_upper_2.stl
Build/Tooling/print/equalizer_guard.stl
Build/Tooling/print/four_finger_lid.stl
Build/Tooling/print/four_finger_palm.stl
Build/Tooling/print/gripper_body.stl
Build/Tooling/print/gripper_jaw_1.stl
Build/Tooling/print/pin_collar.stl
Build/Tooling/print/pin_housing_cover.stl
Build/Tooling/print/receiver.stl
Build/Tooling/print/shaft_coupling_fit_coupon.stl
Build/Tooling/print/socket_coupon_15.stl
Build/Tooling/print/socket_coupon_25.stl
Build/Tooling/print/socket_coupon_35.stl
Build/Tooling/print/soft_finger_print_four.stl
Build/Tooling/print/spatula_clamp.stl
Build/Tooling/print/spatula_holder.stl
Build/Tooling/print/stirrer_back_shell.stl
Build/Tooling/print/stirrer_front_shell.stl
Build/Tooling/print/stirrer_lid.stl
Build/Tooling/print/tendon_equalizer_primary.stl
Build/Tooling/print/tendon_equalizer_secondary.stl
Build/Tooling/print/tendon_spool.stl
Build/Tooling/print/test_plug.stl
