jdragon3001/SO-ARM100/Build/Tooling/inspection/wrist-preview.png

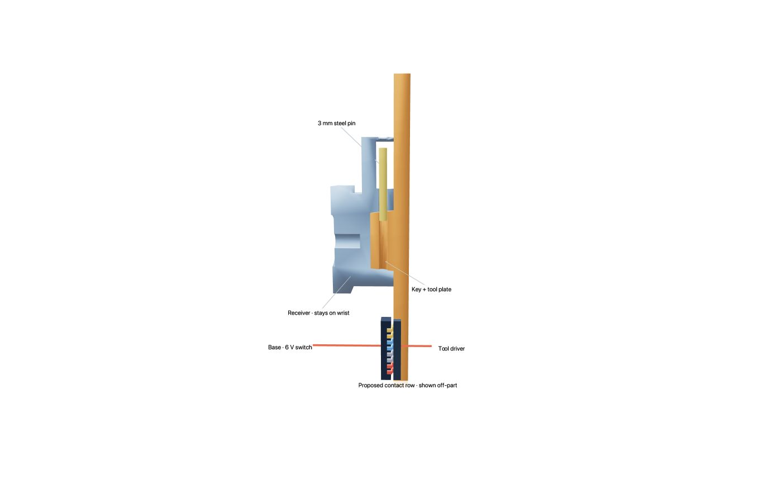
Build/Tooling/inspection/wrist-preview.png
