jdragon3001/SO-ARM100/Build/Tooling/previews/four_modules.png

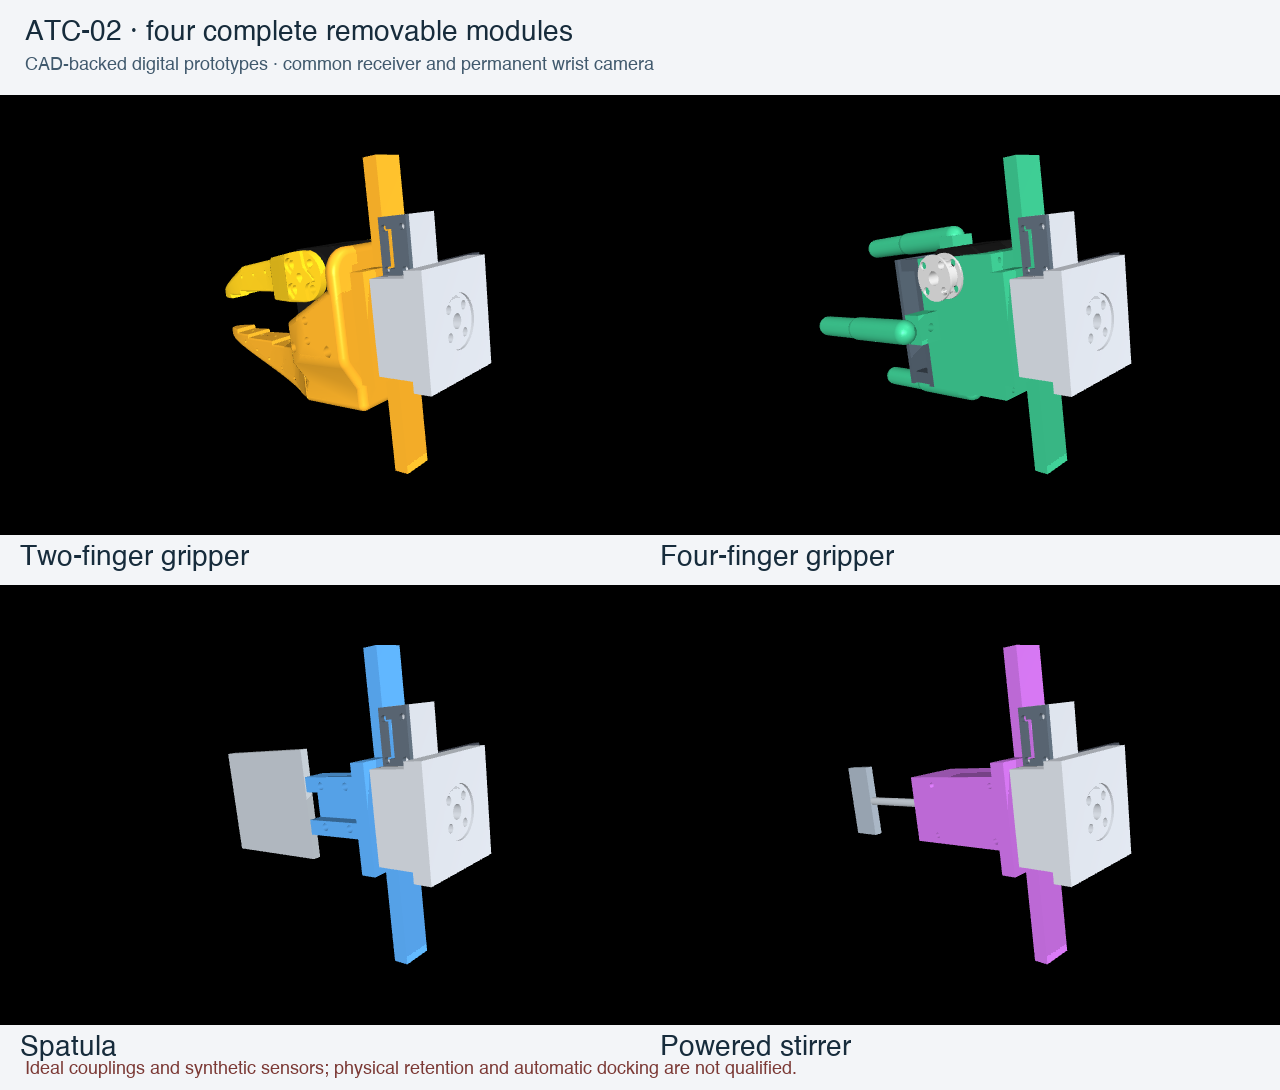
Build/Tooling/previews/four_modules.png
