jdragon3001/SO-ARM100/Build/Tooling/previews/gripper.png

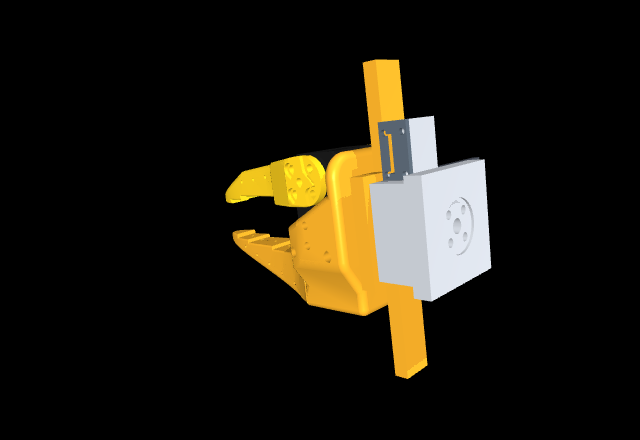
Build/Tooling/previews/gripper.png
