jdragon3001/SO-ARM100/Build/Tooling/previews/spatula.png

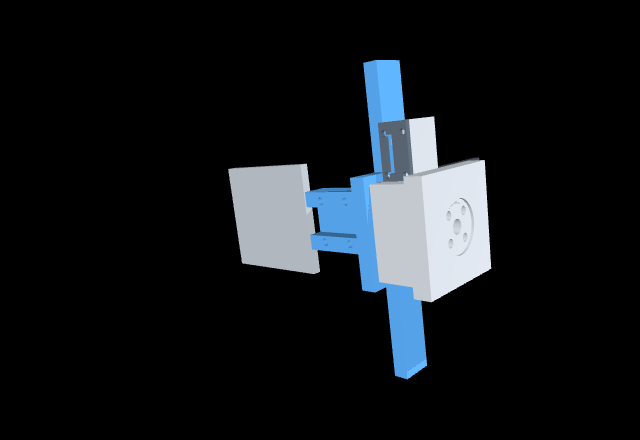
Build/Tooling/previews/spatula.png
