jdragon3001/SO-ARM100/Build/workbench-preview.png

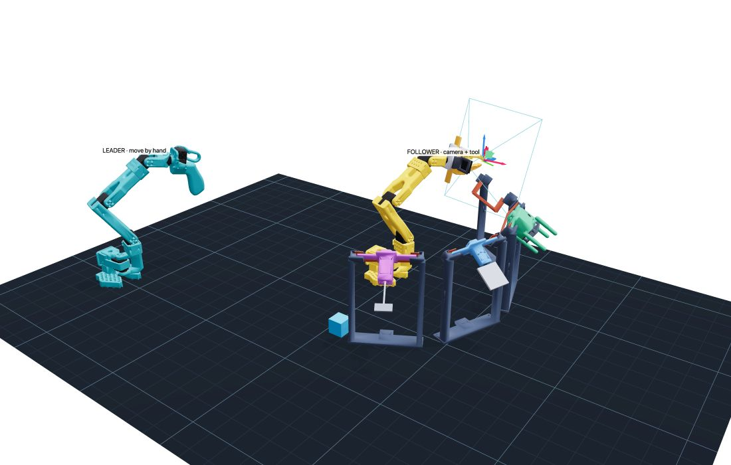
Build/workbench-preview.png
