jdragon3001/SO-ARM100/(commit log)

2026-11-04 Add SO-101 leader/follower simulation and A1 mini build workspace
    [follower_plate_01.stl, follower_plate_02.stl, follower_plate_03.stl, leader_plate_01.stl, leader_plate_02.stl, leader_plate_03.stl]
2026-11-07 Prototype automatic tool changes with four modules, CAD, and interlocks
    [BOM.csv, camera_bracket_32mm.step, camera_bracket_32mm.stl, contact_carrier_fit_coupon.step, contact_carrier_fit_coupon.stl, dock_gripper.step, dock_gripper.stl, dock_gripper_lower_1.step]
2026-11-07 Fix tool rack interference and verify rendered clearance
    [dock_gripper.step, dock_gripper.stl, dock_gripper_lower_1.step, dock_gripper_lower_1.stl, dock_gripper_upper_1.step, dock_gripper_upper_1.stl, dock_gripper_upper_2.step, dock_gripper_upper_2.stl]
2026-11-07 Show wrist lock, power path, and powered tool motion
    [receiver_section.stl, test_plug_section.stl]
